kelflanagan/Doorbell-Hardware-v2/BOM1.xlsx

Part | Value | Device | Package
R14 | 20 | RESISTOR0603 | 0603_RESISTOR
R15 | 20 | RESISTOR0603 | 0603_RESISTOR
R16 | 20 | RESISTOR0603 | 0603_RESISTOR
FB1 | 22 | FB0805 | 0805_FB
FB2 | 600 | FB0805 | 0805_FB
FB3 | 600 | FB0805 | 0805_FB
R12 | 680 | RESISTOR0603 | 0603_RESISTOR
R18 | 680 | RESISTOR0603 | 0603_RESISTOR
R22 | 680 | RESISTOR0603 | 0603_RESISTOR
R25 | 680 | RESISTOR0603 | 0603_RESISTOR
R28 | 680 | RESISTOR0603 | 0603_RESISTOR
C5 | 0.01uF 50V | CAP0603 | 0603_CAP
C7 | 0.01uF 50V | CAP0603 | 0603_CAP
C11 | 0.047uF 50V | CAP0603 | 0603_CAP
C1 | 0.1uF | CAP0603 | 0603_CAP
C4 | 0.1uF | CAP0603 | 0603_CAP
C6 | 0.1uF | CAP0603 | 0603_CAP
C8 | 0.1uF | CAP0603 | 0603_CAP
C9 | 0.1uF | CAP0603 | 0603_CAP
C10 | 0.1uF | CAP0603 | 0603_CAP
C13 | 0.1uF | CAP0603 | 0603_CAP
C16 | 0.1uF | CAP0603 | 0603_CAP
C17 | 0.1uF | CAP0603 | 0603_CAP
C18 | 0.1uF | CAP0603 | 0603_CAP
C19 | 0.1uF | CAP0603 | 0603_CAP
C21 | 0.1uF | CAP0603 | 0603_CAP
C23 | 0.1uF | CAP0603 | 0603_CAP
C24 | 0.1uF | CAP0603 | 0603_CAP
C25 | 0.1uF | CAP0603 | 0603_CAP
C36 | 0.1uF 50V | CAP0603 | 0603_CAP
C31 | 0.47uF | CAP0603 | 0603_CAP
R2 | 100k | RESISTOR0603 | 0603_RESISTOR
R7 | 100k | RESISTOR0603 | 0603_RESISTOR
R8 | 100k | RESISTOR0603 | 0603_RESISTOR
R9 | 100k | RESISTOR0603 | 0603_RESISTOR
R13 | 100k | RESISTOR0603 | 0603_RESISTOR
R21 | 100k | RESISTOR0603 | 0603_RESISTOR
C28 | 100uF | CAP_POLF | F_CAP
C39 | 100uF | CAP_POLF | F_CAP
R1 | 10k | RESISTOR0603 | 0603_RESISTOR
R3 | 10k | RESISTOR0603 | 0603_RESISTOR
R4 | 10k | RESISTOR0603 | 0603_RESISTOR
R6 | 10k | RESISTOR0603 | 0603_RESISTOR
R10 | 10k | RESISTOR0603 | 0603_RESISTOR
R17 | 10k | RESISTOR0603 | 0603_RESISTOR
R29 | 10k | RESISTOR0603 | 0603_RESISTOR
R30 | 10k | RESISTOR0603 | 0603_RESISTOR
R31 | 10k | RESISTOR0603 | 0603_RESISTOR
C12 | 10uF | CAP_POLB | B_CAP
C22 | 10uF | CAP_POLB | B_CAP
X1 | 12.288 MHz | CRYSTAL5X3 | CRYSTAL_5X3
C38 | 1500uF | CAP_POLJ16 | J16_CAP
C41 | 1500uF | CAP_POLJ16 | J16_CAP
C2 | 18pF | CAP0603 | 0603_CAP
C3 | 18pF | CAP0603 | 0603_CAP
C14 | 18pF | CAP0603 | 0603_CAP
C15 | 18pF | CAP0603 | 0603_CAP
R5 | 1M | RESISTOR0603 | 0603_RESISTOR
L1 | 1mH | DR125 | DR125
C30 | 1uF | CAP0603 | 0603_CAP
C32 | 1uF | CAP0603 | 0603_CAP
C37 | 1uF | CAP0603 | 0603_CAP
C43 | 1uF | CAP0603 | 0603_CAP
C26 | 1uF | CAP0805 | 0805_CAP
C27 | 1uF | CAP0805 | 0805_CAP
C29 | 1uF | CAP0805 | 0805_CAP
C35 | 1uF | CAP0805 | 0805_CAP
R19 | 20k | RESISTOR0603 | 0603_RESISTOR
R20 | 20k | RESISTOR0603 | 0603_RESISTOR
R23 | 220 5% 3W | RESISTOR4122 | 4122_RESISTOR
R26 | 220 5% 3W | RESISTOR4122 | 4122_RESISTOR
C33 | 330pF | CAP0603 | 0603_CAP
C34 | 330pF | CAP0603 | 0603_CAP
C40 | 330uF | CAP_POLF | F_CAP
R24 | 5600 1% .25W | RESISTOR1206 | 1206_RESISTOR
R27 | 5600 1% .25W | RESISTOR1206 | 1206_RESISTOR
X2 | 8 MHz | CRYSTAL5X3 | CRYSTAL_5X3
C42 | 8.2pF | CAP0603 | 0603_CAP
IC1 | AT90USB1286 | AT90USB1286 | TQFP64
MCU1 | ATM328P | ATMEGA328P | TQFP32-08
LED1 | GRN | LED0603 | 0603_LED
LED2 | GRN | LED0603 | 0603_LED
LED3 | GRN | LED0603 | 0603_LED
OPTO1 | H11L1M | H11L1M | SOIC6
OPTO2 | H11L1M | H11L1M | SOIC6
HD1 | HEADER_2X3 | HEADER_2X3 | HEADER_2X3
HD2 | HEADER_2X3 | HEADER_2X3 | HEADER_2X3
MAX1 | MAX9737 | MAX9737 | TQFN24
TB1 | TERMINAL_BLOCK_2 | TERMINAL_BLOCK_2 | TERMINAL_BLOCK_2
TB2 | TERMINAL_BLOCK_2 | TERMINAL_BLOCK_2 | TERMINAL_BLOCK_2
TB3 | TERMINAL_BLOCK_2 | TERMINAL_BLOCK_2 | TERMINAL_BLOCK_2
TB4 | TERMINAL_BLOCK_2 | TERMINAL_BLOCK_2 | TERMINAL_BLOCK_2
VS1011 | VS1011 | VS1011 | LQFP-48
XBEEWIFI | XBEE_WIFI | XBEE_WIFI | XBEE_WIFI
IC2 |  | AT45DB642D | 28T-TSOP-1
B1 |  | BR | DFS
D1 |  | DIODE0603 | 0603_DIODE
D2 |  | DIODE0603 | 0603_DIODE
Z1 |  | SCHOTTKY_DIODE | SMD_DIODE
RESET |  | SWITCH | SWITCH_TAC
RESET_WIFI |  | SWITCH | SWITCH_TAC
REG1 |  | TL2575 | TO-263-5
