kelflanagan/Doorbell-Hardware-v2/doorbell.xlsx

Qty | Value | Device | Package | Parts | Description | DIGIKEY# | MANF | MANF#
1 |  | AT45DB642D | 28T-TSOP-1 | IC2 |  | 1265-1010-ND | Adesto Technologies | AT45DB642D-TU
1 |  | BR | DFS | B1 |  | 641-1425-1-ND | Comchip Technology | DF206ST-G
2 |  | DIODE0603 | 0603_DIODE | D1, D2 |  | 641-1002-1-ND | Comchip Technology | CDSU101A
1 |  | PINHD-1X1 | 1X01 | E_CLK | PIN HEADER
1 |  | SCHOTTKY_DIODE | SMD_DIODE | Z1 |  | 1N5819HW-FDICT-ND | Diodes Inc | 1N5819HW-7-F
2 |  | SWITCH | SWITCH_TAC | RESET, RESET_WIFI |  | EG4576CT-ND | E-Switch | TL3302AF180QJ
1 |  | TL2575 | TO-263-5 | REG1 |  | 296-21828-1-ND | Texas Instruments | TL2575-33IKTTR
2 | 0.01uF 50V | CAP0603 | 0603_CAP | C5, C7
1 | 0.047uF 50V | CAP0603 | 0603_CAP | C11
15 | 0.1uF | CAP0603 | 0603_CAP | C1, C4, C6, C8, C9, C10, C13, C16, C17, C18, C19, C21, C23, C24, C25
1 | 0.1uF 50V | CAP0603 | 0603_CAP | C36
1 | 0.47uF | CAP0603 | 0603_CAP | C31
1 | 1000uH | DR125 | DR125 | L1 |  | SRR1208-102KLCT-ND | Bourns Inc. | SRR1208-102KL
6 | 100k | RESISTOR0603 | 0603_RESISTOR | R2, R7, R8, R9, R13, R21
2 | 100uF | CAP_POLF | F_CAP | C28, C39
9 | 10k | RESISTOR0603 | 0603_RESISTOR | R1, R3, R4, R6, R10, R17, R29, R30, R31
2 | 10uF | CAP_POLB | B_CAP | C12, C22
1 | 12.288 MHz | CRYSTAL5X3 | CRYSTAL_5X3 | X1
2 | 1500uF | CAP_POLJ16 | J16_CAP | C38, C41
4 | 18pF | CAP0603 | 0603_CAP | C2, C3, C14, C15
1 | 1M | RESISTOR0603 | 0603_RESISTOR | R5
4 | 1uF | CAP0603 | 0603_CAP | C30, C32, C37, C43
4 | 1uF | CAP0805 | 0805_CAP | C26, C27, C29, C35
3 | 20 | RESISTOR0603 | 0603_RESISTOR | R14, R15, R16
2 | 20k | RESISTOR0603 | 0603_RESISTOR | R19, R20
2 | 220 5% 3W | RESISTOR4122 | 4122_RESISTOR | R23, R26
1 | 22uH | FB0805 | 0805_FB | FB1
2 | 330pF | CAP0603 | 0603_CAP | C33, C34
1 | 330uF | CAP_POLF | F_CAP | C40
2 | 5600 1% .25W | RESISTOR1206 | 1206_RESISTOR | R24, R27
2 | 600 | FB0805 | 0805_FB | FB2, FB3
5 | 680 | RESISTOR0603 | 0603_RESISTOR | R12, R18, R22, R25, R28
1 | 8 MHz | CRYSTAL5X3 | CRYSTAL_5X3 | X2
1 | 8.2pF | CAP0603 | 0603_CAP | C42
1 | AT90USB1286 | AT90USB1286 | TQFP64 | IC1 |  | AT90USB1286-AURCT-ND | Atmel | AT90USB1286-AUR
1 | ATM328P | ATMEGA328P | TQFP32-08 | MCU1 |  | ATMEGA328P-AURCT-ND | Atmel | ATMEGA328P-AUR
3 | GRN | LED0603 | 0603_LED | LED1, LED2, LED3 |  | 516-2493-1-ND | Avago Technologies | HSMG-C191
2 | H11L1M | H11L1M | SOIC6 | OPTO1, OPTO2 |  | H11L1SM-ND | Fairchild Semiconductor | H11L1SM
2 | HEADER_2X3 | HEADER_2X3 | HEADER_2X3 | HD1, HD2 |  | 609-3487-1-ND | FCI | 95278-101A06LF
1 | MAX9737 | MAX9737 | TQFN24 | MAX1 |  | MAX9737ETG+TCT-ND | Maxim | MAX9737ETG+T
2 | STAND-OFF | STAND-OFF | STAND-OFF | JP1, JP3 | #4 Stand Off
4 | TERMINAL_BLOCK_2 | TERMINAL_BLOCK_2 | TERMINAL_BLOCK_2 | TB1, TB2, TB3, TB4 |  | 277-2072-1-ND | Phoenix | 1771091
1 | VS1011 | VS1011 | LQFP-48 | VS1011 |  |  | VLSI | VS1011E-L
1 | XBEE_WIFI | XBEE_WIFI | XBEE_WIFI | XBEEWIFI |  | 602-1369-ND | Digi International | XB2B-WFPS-001
