kelflanagan/Doorbell-Hardware-v2/doorbell.brd

## EAGLE design doorbell.brd (2016-05-04)

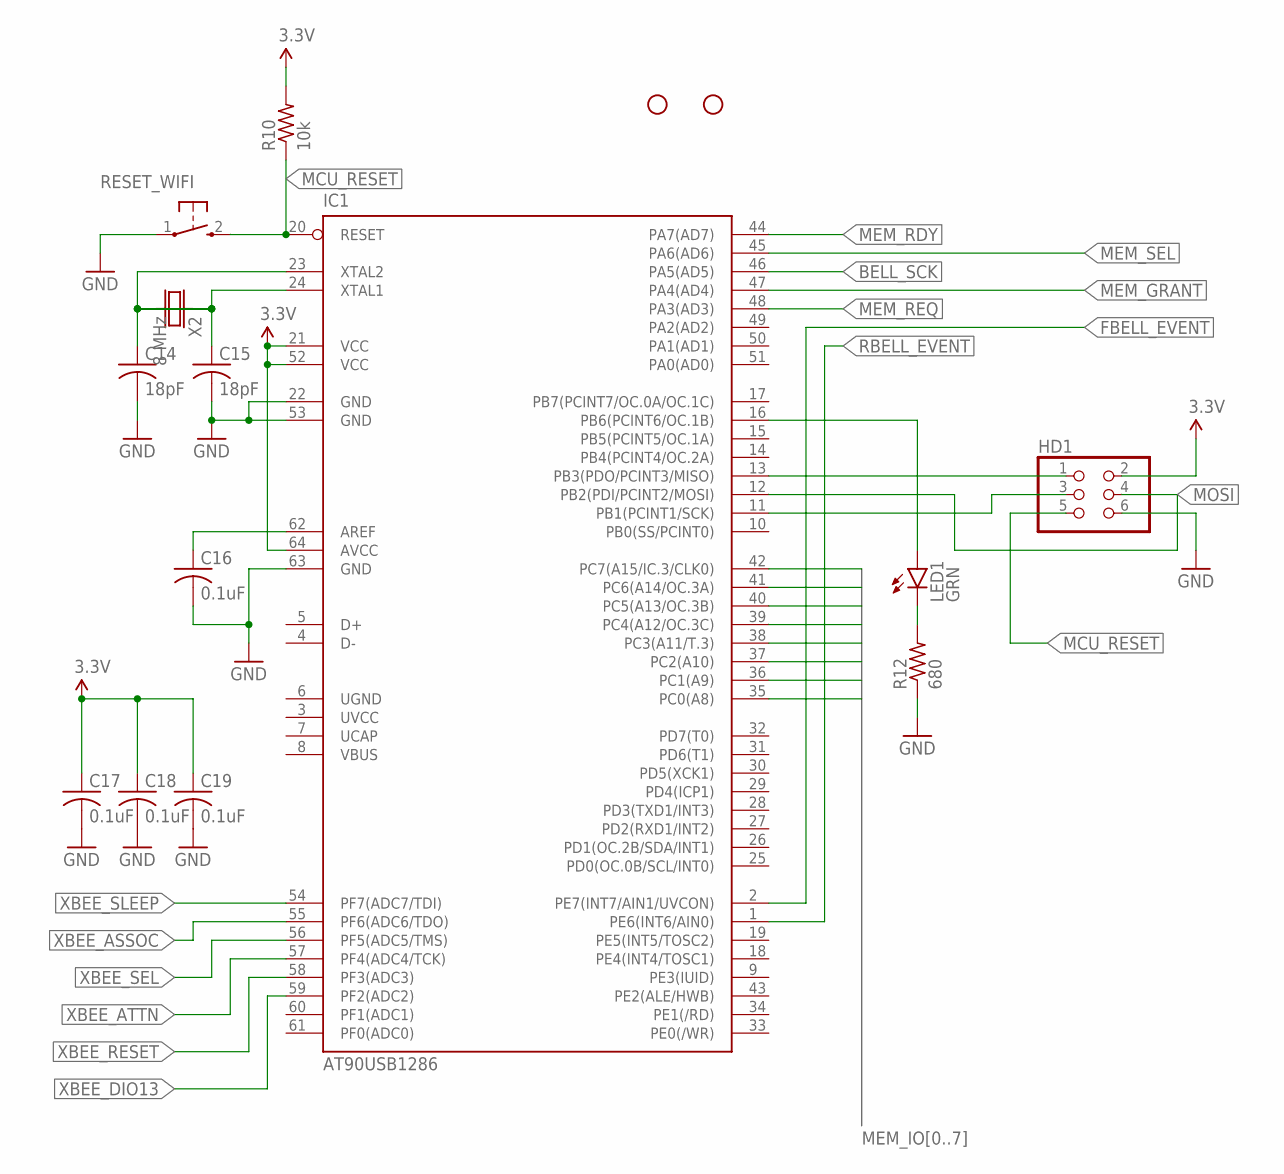
[picture p1: schematic doorbell.sch, sheet 1]

Parts:
C14, C15: 18pF; 0603_CAP
C16, C17, C18, C19: 0.1uF; 0603_CAP
HD1: HEADER_2X3
IC1: AT90USB1286; TQFP64
JP1, JP3: STAND-OFF
LED1: GRN; 0603_LED
R10: 10k; 0603_RESISTOR
R12: 680; 0603_RESISTOR
RESET_WIFI: SWITCH; SWITCH_TAC
X2: 8 MHz; CRYSTAL_5X3

Connections:
3.3V: C17.1, C18.1, C19.1, HD1.2, IC1.21 (VCC), IC1.52 (VCC), IC1.64 (AVCC), R10.2; also elsewhere on the board
BELL_SCK: IC1.46 (PA5(AD5)); also elsewhere on the board
FBELL_EVENT: IC1.2 (PE7(INT7/AIN1/UVCON)); also elsewhere on the board
GND: C14.2, C15.2, C16.2, C17.2, C18.2, C19.2, HD1.6, IC1.22 (GND), IC1.53 (GND), IC1.63 (GND), R12.1, RESET_WIFI.1; also elsewhere on the board
MCU_RESET: HD1.5, IC1.20 (RESET), R10.1, RESET_WIFI.2
MEM_GRANT: IC1.47 (PA4(AD4)); also elsewhere on the board
MEM_IO0: IC1.35 (PC0(A8)); also elsewhere on the board
MEM_IO1: IC1.36 (PC1(A9)); also elsewhere on the board
MEM_IO2: IC1.37 (PC2(A10)); also elsewhere on the board
MEM_IO3: IC1.38 (PC3(A11/T.3)); also elsewhere on the board
MEM_IO4: IC1.39 (PC4(A12/OC.3C)); also elsewhere on the board
MEM_IO5: IC1.40 (PC5(A13/OC.3B)); also elsewhere on the board
MEM_IO6: IC1.41 (PC6(A14/OC.3A)); also elsewhere on the board
MEM_IO7: IC1.42 (PC7(A15/IC.3/CLK0)); also elsewhere on the board
MEM_RDY: IC1.44 (PA7(AD7)); also elsewhere on the board
MEM_REQ: IC1.48 (PA3(AD3)); also elsewhere on the board
MEM_SEL: IC1.45 (PA6(AD6)); also elsewhere on the board
MISO: HD1.1, IC1.13 (PB3(PDO/PCINT3/MISO)); also elsewhere on the board
MOSI: HD1.4, IC1.12 (PB2(PDI/PCINT2/MOSI)); also elsewhere on the board
unnamed: C14.1, IC1.23 (XTAL2), X2.1
unnamed: C15.1, IC1.24 (XTAL1), X2.2
unnamed: LED1.C, R12.2
unnamed: IC1.16 (PB6(PCINT6/OC.1B)), LED1.A
unnamed: C16.1, IC1.62 (AREF)
RBELL_EVENT: IC1.1 (PE6(INT6/AIN0)); also elsewhere on the board
SCK: HD1.3, IC1.11 (PB1(PCINT1/SCK)); also elsewhere on the board
UCAP: IC1.7 (UCAP)
UGND: IC1.6 (UGND)
UVCC: IC1.3 (UVCC)
VBUS: IC1.8 (VBUS)
XBEE_ASSOC: IC1.55 (PF6(ADC6/TDO)); also elsewhere on the board
XBEE_ATTN: IC1.57 (PF4(ADC4/TCK)); also elsewhere on the board
XBEE_DIO13: IC1.59 (PF2(ADC2)); also elsewhere on the board
XBEE_RESET: IC1.58 (PF3(ADC3)); also elsewhere on the board
XBEE_SEL: IC1.56 (PF5(ADC5/TMS)); also elsewhere on the board
XBEE_SLEEP: IC1.54 (PF7(ADC7/TDI)); also elsewhere on the board

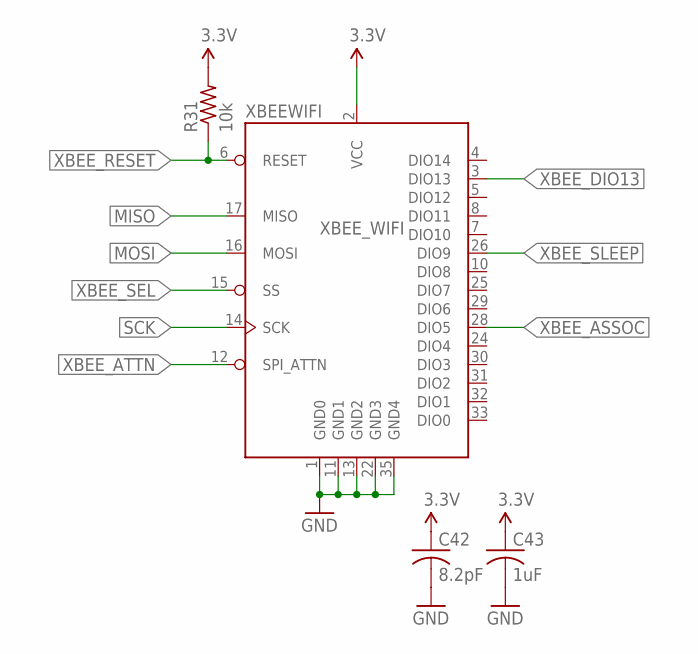
[picture p2: schematic doorbell.sch, sheet 2]

Parts:
C42: 8.2pF; 0603_CAP
C43: 1uF; 0603_CAP
R31: 10k; 0603_RESISTOR
XBEEWIFI: XBEE_WIFI

Connections:
3.3V: C42.1, C43.1, R31.2, XBEEWIFI.2 (VCC); also elsewhere on the board
GND: C42.2, C43.2, XBEEWIFI.1 (GND0), XBEEWIFI.11 (GND1), XBEEWIFI.13 (GND2), XBEEWIFI.22 (GND3), XBEEWIFI.35 (GND4); also elsewhere on the board
MISO: XBEEWIFI.17 (MISO); also elsewhere on the board
MOSI: XBEEWIFI.16 (MOSI); also elsewhere on the board
SCK: XBEEWIFI.14 (SCK); also elsewhere on the board
XBEE_ASSOC: XBEEWIFI.28 (DIO5); also elsewhere on the board
XBEE_ATTN: XBEEWIFI.12 (SPI_ATTN); also elsewhere on the board
XBEE_DIO13: XBEEWIFI.3 (DIO13); also elsewhere on the board
XBEE_RESET: R31.1, XBEEWIFI.6 (RESET); also elsewhere on the board
XBEE_SEL: XBEEWIFI.15 (SS); also elsewhere on the board
XBEE_SLEEP: XBEEWIFI.26 (DIO9); also elsewhere on the board

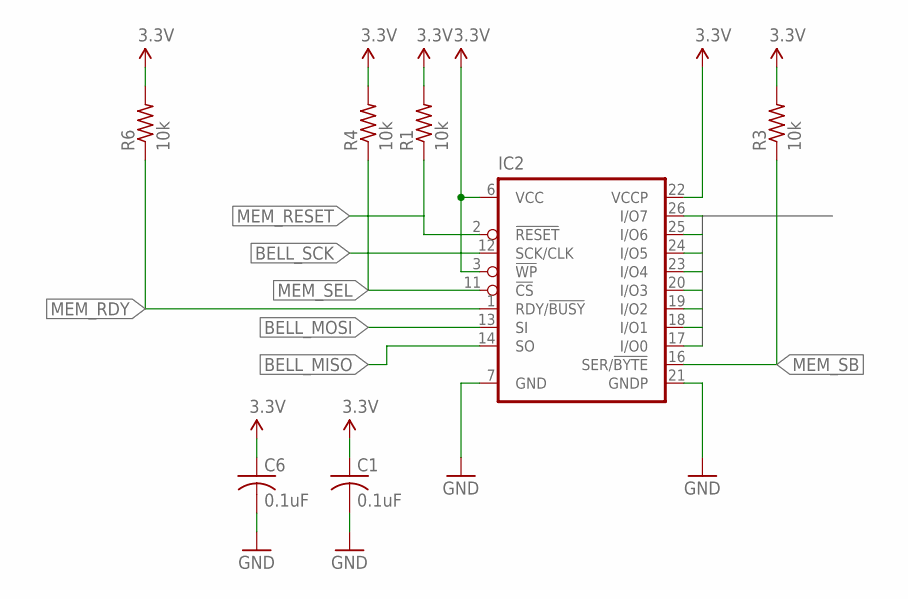
[picture p3: schematic doorbell.sch, sheet 3]

Parts:
C1, C6: 0.1uF; 0603_CAP
IC2: AT45DB642D; 28T-TSOP-1
R1, R3, R4, R6: 10k; 0603_RESISTOR

Connections:
3.3V: C1.1, C6.1, IC2.3 (!WP), IC2.6 (VCC), IC2.22 (VCCP), R1.2, R3.2, R4.2, R6.2; also elsewhere on the board
BELL_MISO: IC2.14 (SO); also elsewhere on the board
BELL_MOSI: IC2.13 (SI); also elsewhere on the board
BELL_SCK: IC2.12 (SCK/CLK); also elsewhere on the board
GND: C1.2, C6.2, IC2.7 (GND), IC2.21 (GNDP); also elsewhere on the board
MEM_IO0: IC2.17 (I/O0); also elsewhere on the board
MEM_IO1: IC2.18 (I/O1); also elsewhere on the board
MEM_IO2: IC2.19 (I/O2); also elsewhere on the board
MEM_IO3: IC2.20 (I/O3); also elsewhere on the board
MEM_IO4: IC2.23 (I/O4); also elsewhere on the board
MEM_IO5: IC2.24 (I/O5); also elsewhere on the board
MEM_IO6: IC2.25 (I/O6); also elsewhere on the board
MEM_IO7: IC2.26 (I/O7); also elsewhere on the board
MEM_RDY: IC2.1 (RDY/!BUSY), R6.1; also elsewhere on the board
MEM_RESET: IC2.2 (!RESET), R1.1; also elsewhere on the board
MEM_SB: IC2.16 (SER/!BYTE), R3.1; also elsewhere on the board
MEM_SEL: IC2.11 (!CS), R4.1; also elsewhere on the board

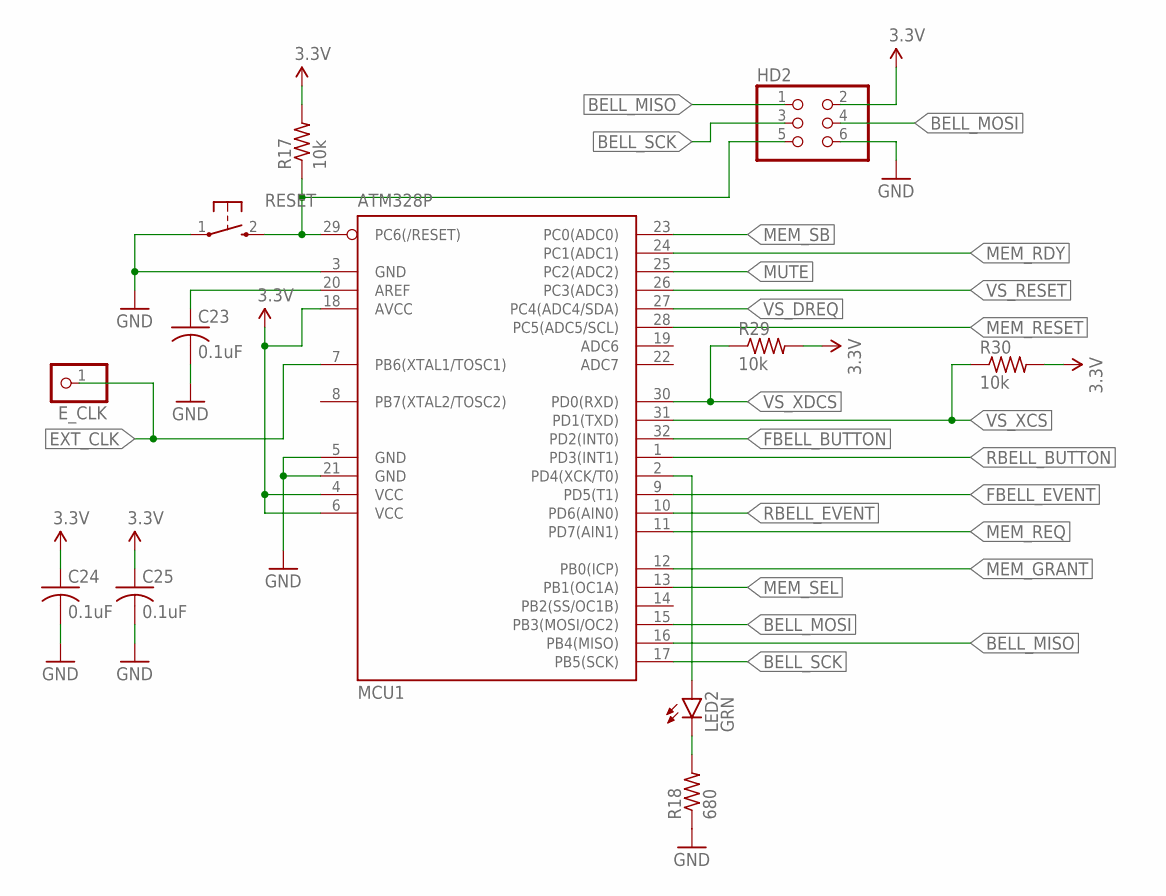
[picture p4: schematic doorbell.sch, sheet 4]

Parts:
C23, C24, C25: 0.1uF; 0603_CAP
E_CLK: PINHD-1X1; 1X01
HD2: HEADER_2X3
LED2: GRN; 0603_LED
MCU1: ATM328P; TQFP32-08
R17, R29, R30: 10k; 0603_RESISTOR
R18: 680; 0603_RESISTOR
RESET: SWITCH; SWITCH_TAC

Connections:
3.3V: C24.1, C25.1, HD2.2, MCU1.4 (VCC), MCU1.6 (VCC), MCU1.18 (AVCC), R17.2, R29.2, R30.2; also elsewhere on the board
BELL_MISO: HD2.1, MCU1.16 (PB4(MISO)); also elsewhere on the board
BELL_MOSI: HD2.4, MCU1.15 (PB3(MOSI/OC2)); also elsewhere on the board
BELL_RESET: HD2.5, MCU1.29 (PC6(/RESET)), R17.1, RESET.2
BELL_SCK: HD2.3, MCU1.17 (PB5(SCK)); also elsewhere on the board
EXT_CLK: E_CLK.1, MCU1.7 (PB6(XTAL1/TOSC1))
FBELL_BUTTON: MCU1.32 (PD2(INT0)); also elsewhere on the board
FBELL_EVENT: MCU1.9 (PD5(T1)); also elsewhere on the board
GND: C23.2, C24.2, C25.2, HD2.6, MCU1.3 (GND), MCU1.5 (GND), MCU1.21 (GND), R18.1, RESET.1; also elsewhere on the board
MEM_GRANT: MCU1.12 (PB0(ICP)); also elsewhere on the board
MEM_RDY: MCU1.24 (PC1(ADC1)); also elsewhere on the board
MEM_REQ: MCU1.11 (PD7(AIN1)); also elsewhere on the board
MEM_RESET: MCU1.28 (PC5(ADC5/SCL)); also elsewhere on the board
MEM_SB: MCU1.23 (PC0(ADC0)); also elsewhere on the board
MEM_SEL: MCU1.13 (PB1(OC1A)); also elsewhere on the board
MUTE: MCU1.25 (PC2(ADC2)); also elsewhere on the board
unnamed: C23.1, MCU1.20 (AREF)
unnamed: LED2.C, R18.2
unnamed: LED2.A, MCU1.2 (PD4(XCK/T0))
RBELL_BUTTON: MCU1.1 (PD3(INT1)); also elsewhere on the board
RBELL_EVENT: MCU1.10 (PD6(AIN0)); also elsewhere on the board
VS_DREQ: MCU1.27 (PC4(ADC4/SDA)); also elsewhere on the board
VS_RESET: MCU1.26 (PC3(ADC3)); also elsewhere on the board
VS_XCS: MCU1.31 (PD1(TXD)), R30.1; also elsewhere on the board
VS_XDCS: MCU1.30 (PD0(RXD)), R29.1; also elsewhere on the board

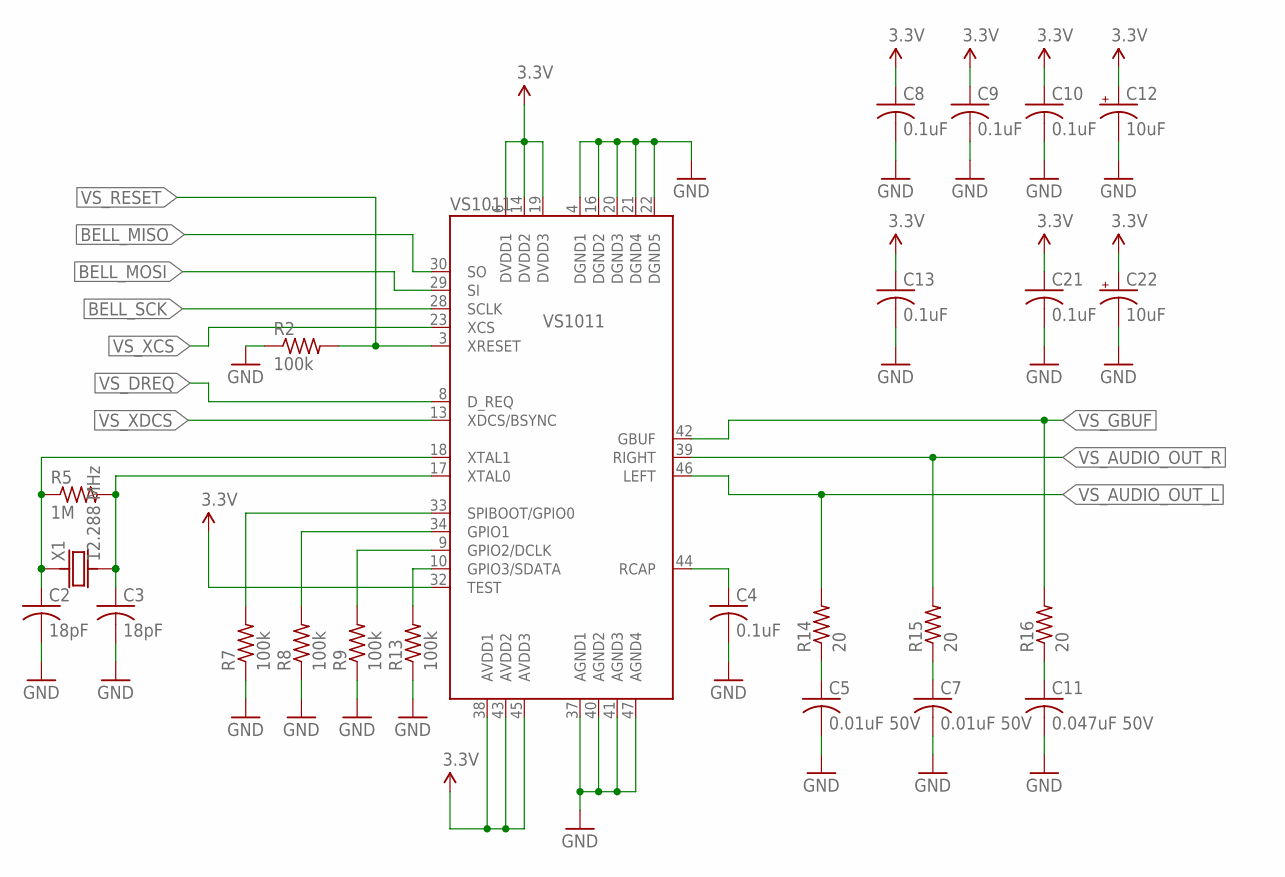
[picture p5: schematic doorbell.sch, sheet 5]

Parts:
C2, C3: 18pF; 0603_CAP
C4, C8, C9, C10, C13, C21: 0.1uF; 0603_CAP
C5, C7: 0.01uF 50V; 0603_CAP
C11: 0.047uF 50V; 0603_CAP
C12, C22: 10uF; B_CAP
R2, R7, R8, R9, R13: 100k; 0603_RESISTOR
R5: 1M; 0603_RESISTOR
R14, R15, R16: 20; 0603_RESISTOR
VS1011: VS1011; LQFP-48
X1: 12.288 MHz; CRYSTAL_5X3

Connections:
3.3V: C8.1, C9.1, C10.1, C12.+, C13.1, C21.1, C22.+, VS1011.6 (DVDD1), VS1011.14 (DVDD2), VS1011.19 (DVDD3), VS1011.32 (TEST), VS1011.38 (AVDD1), VS1011.43 (AVDD2), VS1011.45 (AVDD3); also elsewhere on the board
BELL_MISO: VS1011.30 (SO); also elsewhere on the board
BELL_MOSI: VS1011.29 (SI); also elsewhere on the board
BELL_SCK: VS1011.28 (SCLK); also elsewhere on the board
GND: C2.2, C3.2, C4.2, C5.2, C7.2, C8.2, C9.2, C10.2, C11.2, C12.-, C13.2, C21.2, C22.-, R2.1, R7.1, R8.1, R9.1, R13.1, VS1011.4 (DGND1), VS1011.16 (DGND2), VS1011.20 (DGND3), VS1011.21 (DGND4), VS1011.22 (DGND5), VS1011.37 (AGND1), VS1011.40 (AGND2), VS1011.41 (AGND3), VS1011.47 (AGND4); also elsewhere on the board
unnamed: C2.1, R5.1, VS1011.18 (XTAL1), X1.1
unnamed: C3.1, R5.2, VS1011.17 (XTAL0), X1.2
unnamed: C4.1, VS1011.44 (RCAP)
unnamed: R13.2, VS1011.10 (GPIO3/SDATA)
unnamed: R9.2, VS1011.9 (GPIO2/DCLK)
unnamed: R8.2, VS1011.34 (GPIO1)
unnamed: R7.2, VS1011.33 (SPIBOOT/GPIO0)
unnamed: C5.1, R14.1
unnamed: C7.1, R15.1
unnamed: C11.1, R16.1
VS_AUDIO_OUT_L: R14.2, VS1011.46 (LEFT); also elsewhere on the board
VS_AUDIO_OUT_R: R15.2, VS1011.39 (RIGHT)
VS_DREQ: VS1011.8 (D_REQ); also elsewhere on the board
VS_GBUF: R16.2, VS1011.42 (GBUF)
VS_RESET: R2.2, VS1011.3 (XRESET); also elsewhere on the board
VS_XCS: VS1011.23 (XCS); also elsewhere on the board
VS_XDCS: VS1011.13 (XDCS/BSYNC); also elsewhere on the board

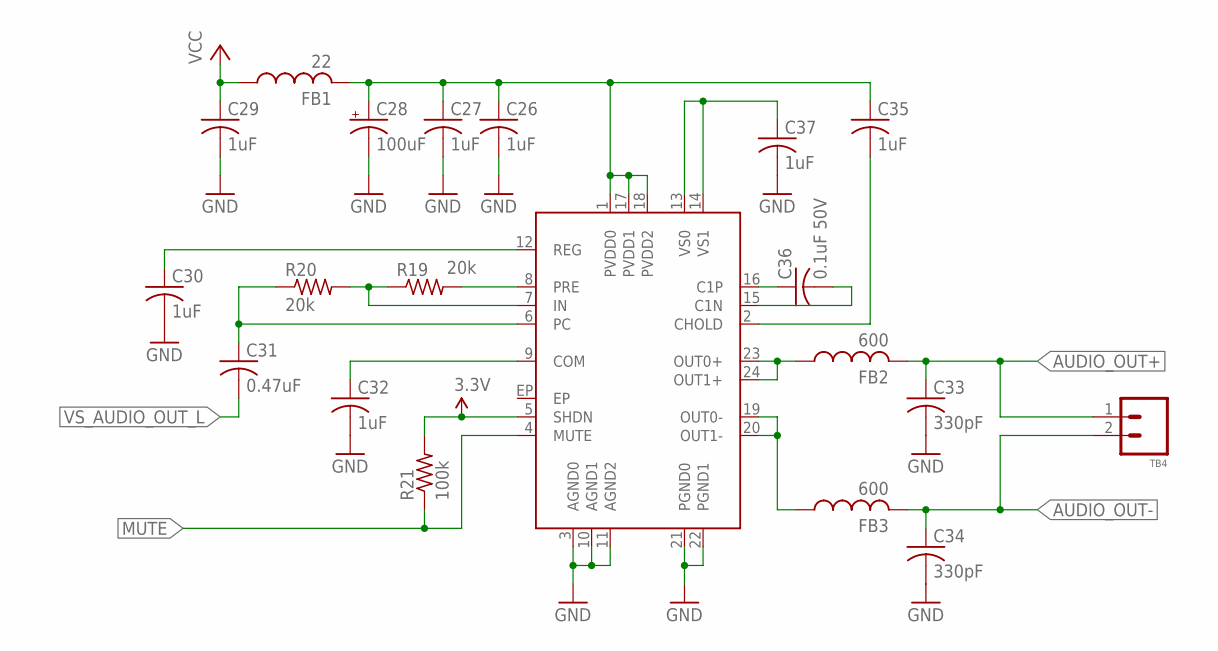
[picture p6: schematic doorbell.sch, sheet 6]

Parts:
C26, C27, C29, C35: 1uF; 0805_CAP
C28: 100uF; F_CAP
C30, C32, C37: 1uF; 0603_CAP
C31: 0.47uF; 0603_CAP
C33, C34: 330pF; 0603_CAP
C36: 0.1uF 50V; 0603_CAP
FB1: 22; 0805_FB
FB2, FB3: 600; 0805_FB
MAX1: MAX9737; TQFN24
R19, R20: 20k; 0603_RESISTOR
R21: 100k; 0603_RESISTOR
TB4: TERMINAL_BLOCK_2

Connections:
3.3V: MAX1.5 (SHDN), R21.2; also elsewhere on the board
AUDIO_OUT+: C33.1, FB2.2, TB4.1
AUDIO_OUT-: C34.1, FB3.2, TB4.2
GND: C26.2, C27.2, C28.-, C29.2, C30.2, C32.2, C33.2, C34.2, C37.2, MAX1.3 (AGND0), MAX1.10 (AGND1), MAX1.11 (AGND2), MAX1.21 (PGND0), MAX1.22 (PGND1); also elsewhere on the board
MUTE: MAX1.4 (MUTE), R21.1; also elsewhere on the board
unnamed: C26.1, C27.1, C28.+, C35.1, FB1.2, MAX1.1 (PVDD0), MAX1.17 (PVDD1), MAX1.18 (PVDD2)
unnamed: C30.1, MAX1.12 (REG)
unnamed: MAX1.8 (PRE), R19.2
unnamed: MAX1.7 (IN), R19.1, R20.2
unnamed: C31.1, MAX1.6 (PC), R20.1
unnamed: C32.1, MAX1.9 (COM)
unnamed: FB3.1, MAX1.19 (OUT0-), MAX1.20 (OUT1-)
unnamed: FB2.1, MAX1.23 (OUT0+), MAX1.24 (OUT1+)
unnamed: C35.2, MAX1.2 (CHOLD)
unnamed: C36.1, MAX1.16 (C1P)
unnamed: C36.2, MAX1.15 (C1N)
unnamed: C37.1, MAX1.13 (VS0), MAX1.14 (VS1)
VCC: C29.1, FB1.1; also elsewhere on the board
VS_AUDIO_OUT_L: C31.2; also elsewhere on the board

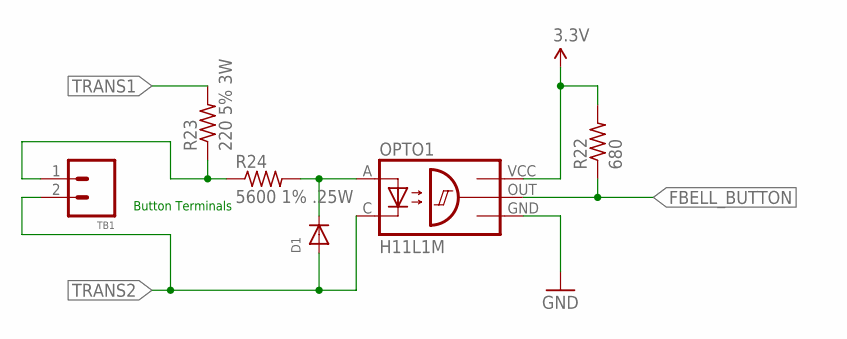
[picture p7: schematic doorbell.sch, sheet 7]

Parts:
D1: DIODE0603; 0603_DIODE
OPTO1: H11L1M; SOIC6
R22: 680; 0603_RESISTOR
R23: 220 5% 3W; 4122_RESISTOR
R24: 5600 1% .25W; 1206_RESISTOR
TB1: TERMINAL_BLOCK_2

Connections:
3.3V: OPTO1.VCC, R22.2; also elsewhere on the board
FBELL_BUTTON: OPTO1.OUT, R22.1; also elsewhere on the board
GND: OPTO1.GND; also elsewhere on the board
unnamed: D1.C, OPTO1.A, R24.2
unnamed: R23.1, R24.1, TB1.1
TRANS1: R23.2; also elsewhere on the board
TRANS2: D1.A, OPTO1.C, TB1.2; also elsewhere on the board

Notes on the sheet:
Button Terminals

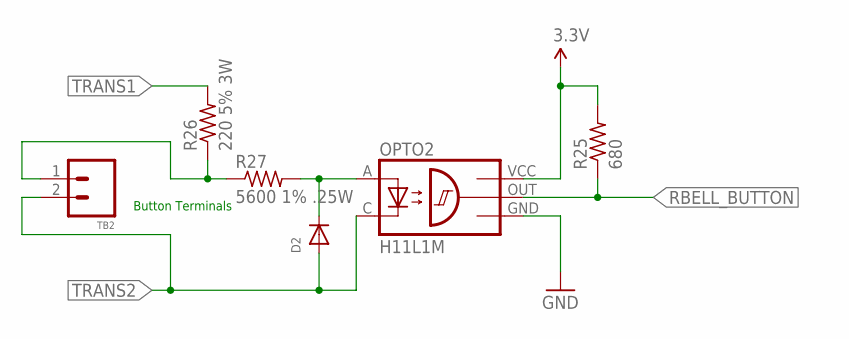
[picture p8: schematic doorbell.sch, sheet 8]

Parts:
D2: DIODE0603; 0603_DIODE
OPTO2: H11L1M; SOIC6
R25: 680; 0603_RESISTOR
R26: 220 5% 3W; 4122_RESISTOR
R27: 5600 1% .25W; 1206_RESISTOR
TB2: TERMINAL_BLOCK_2

Connections:
3.3V: OPTO2.VCC, R25.2; also elsewhere on the board
GND: OPTO2.GND; also elsewhere on the board
unnamed: D2.C, OPTO2.A, R27.2
unnamed: R26.1, R27.1, TB2.1
RBELL_BUTTON: OPTO2.OUT, R25.1; also elsewhere on the board
TRANS1: R26.2; also elsewhere on the board
TRANS2: D2.A, OPTO2.C, TB2.2; also elsewhere on the board

Notes on the sheet:
Button Terminals

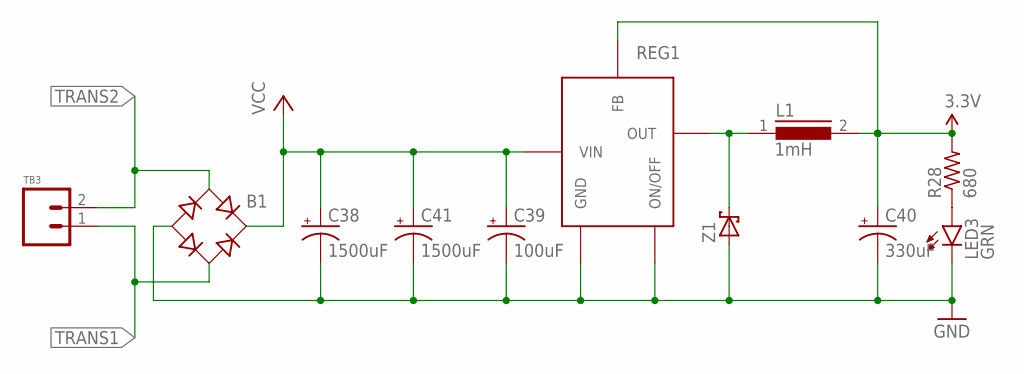
[picture p9: schematic doorbell.sch, sheet 9]

Parts:
B1: BR; DFS
C38, C41: 1500uF; J16_CAP
C39: 100uF; F_CAP
C40: 330uF; F_CAP
L1: 1mH; DR125
LED3: GRN; 0603_LED
R28: 680; 0603_RESISTOR
REG1: TL2575; TO-263-5
TB3: TERMINAL_BLOCK_2
Z1: SCHOTTKY_DIODE; SMD_DIODE

Connections:
3.3V: C40.+, L1.2, R28.2, REG1.4 (FB); also elsewhere on the board
GND: B1.-, C38.-, C39.-, C40.-, C41.-, LED3.C, REG1.3 (GND), REG1.5 (ON/OFF), Z1.A; also elsewhere on the board
unnamed: L1.1, REG1.2 (OUT), Z1.C
unnamed: LED3.A, R28.1
TRANS1: B1.AC2, TB3.1; also elsewhere on the board
TRANS2: B1.AC1, TB3.2; also elsewhere on the board
VCC: B1.+, C38.+, C39.+, C41.+, REG1.1 (VIN); also elsewhere on the board

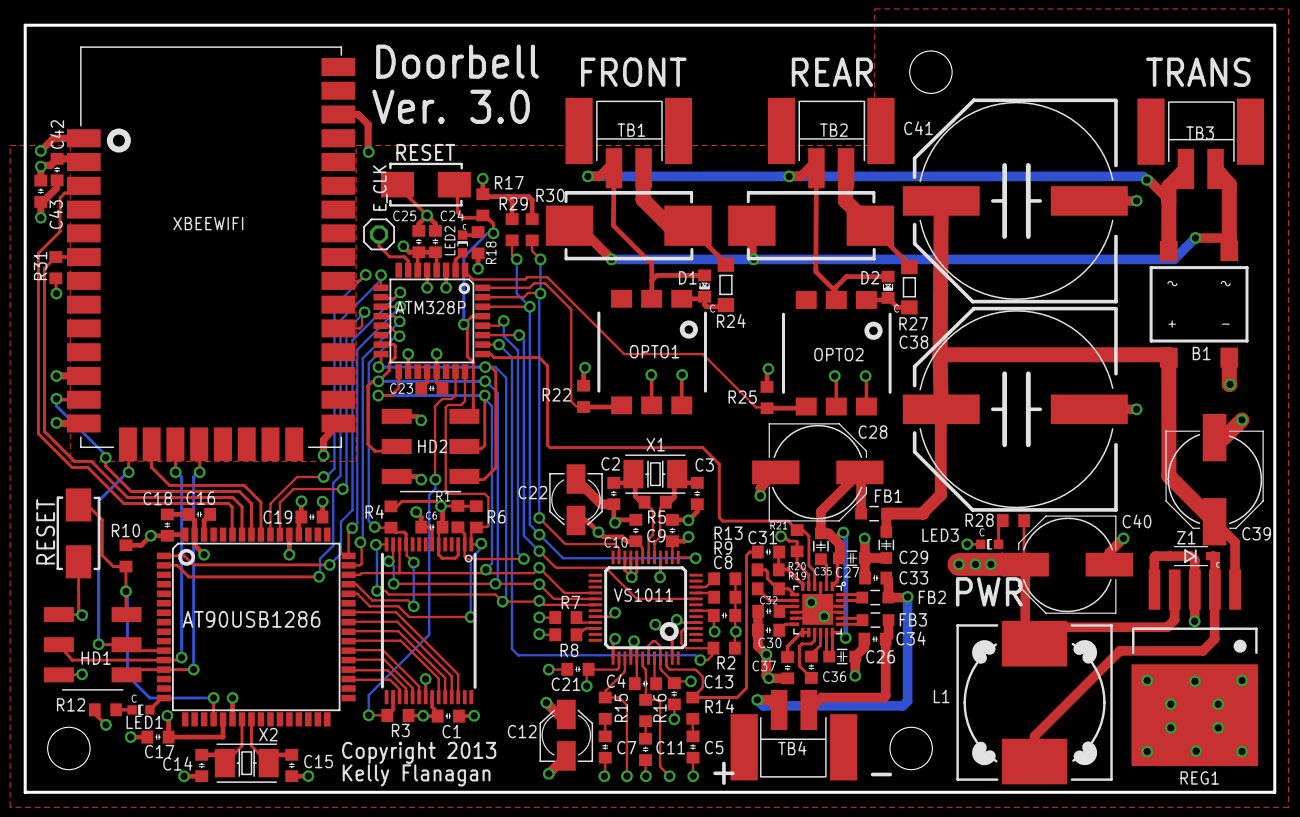
[picture p10: board doorbell.brd from above]

Board: 4 copper layers, 105.5 x 64.8 mm, 106 parts (0 on the bottom side), 84 nets.

Other parts of the board:
JP2: STAND-OFF
