kelflanagan/Doorbell-Hardware-v2/(notices)

Notices in the files:
doorbell.brd:
Copyright 2013
parts and their libraries:
SparkFun-Aesthetics: Licensing: CC v3.0 Share-Alike You are welcome to use this library for commercial purposes.
